MatthewBregg/OpenHopper/STL/BASE BLASTER/Grip/Trigger Grip Assembly.stl

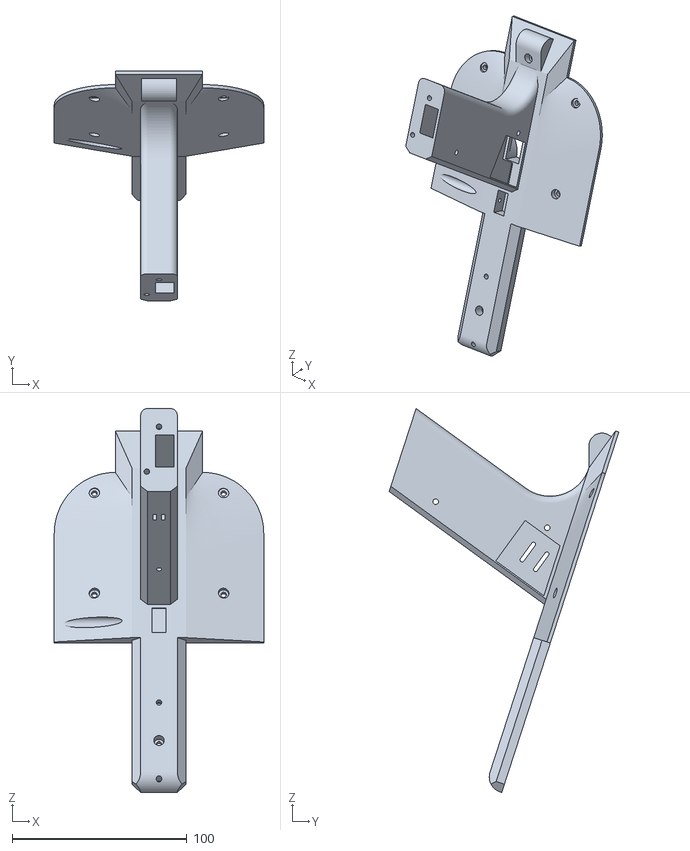
[picture p138: CAD file, 2021-02-06]
STL/BASE BLASTER/Grip/Trigger Grip Assembly.stl
120.0 x 131.6 x 219.9
