MatthewBregg/OpenHopper/STP/Trigger Grip Assembly.step

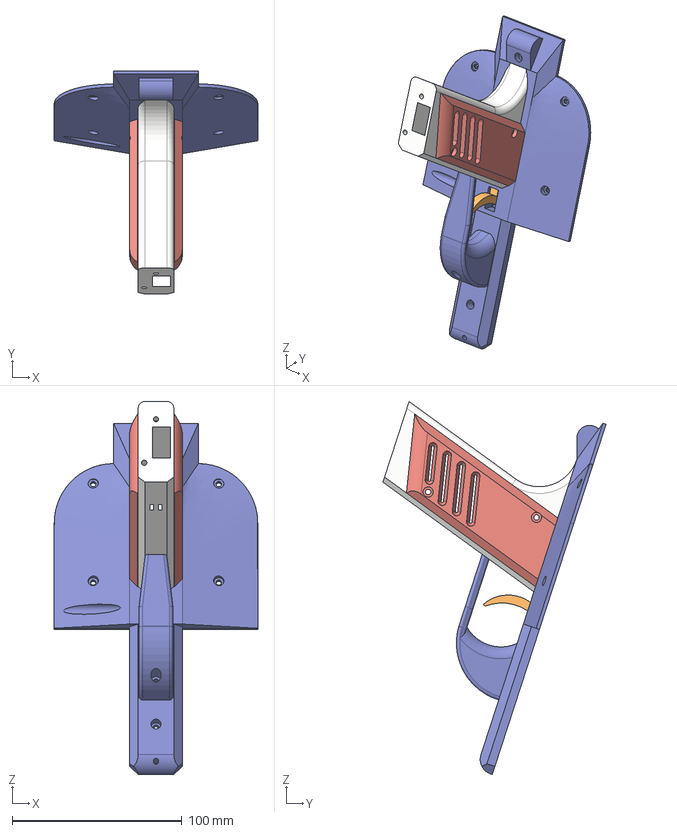
[picture p139: CAD file, 2021-02-24]
STP/Trigger Grip Assembly.step
120.0 x 131.6 x 219.9 mm
Trigger
Trigger Guard
Grip Sides
Grip Sides(Mirror)
