MatthewBregg/OpenHopper/STL/BASE BLASTER/FWC AND COVER/FWC.stl

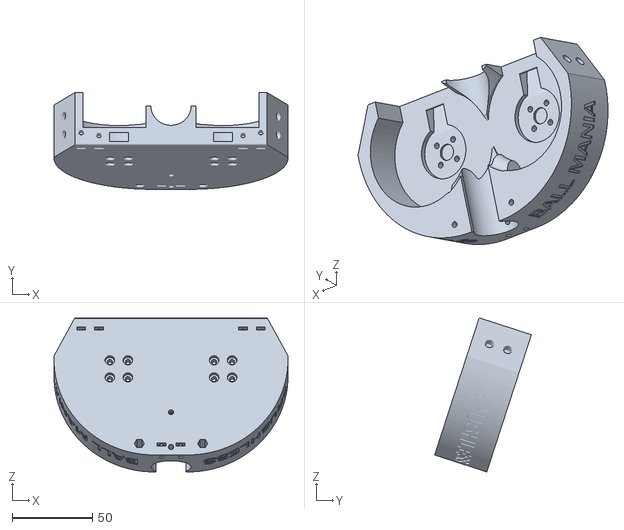
[picture p140: CAD file, 2021-02-22]
STL/BASE BLASTER/FWC AND COVER/FWC.stl
146.0 x 60.4 x 96.0
