MatthewBregg/OpenHopper/STL/BASE BLASTER/Grip/Grip Sides.stl

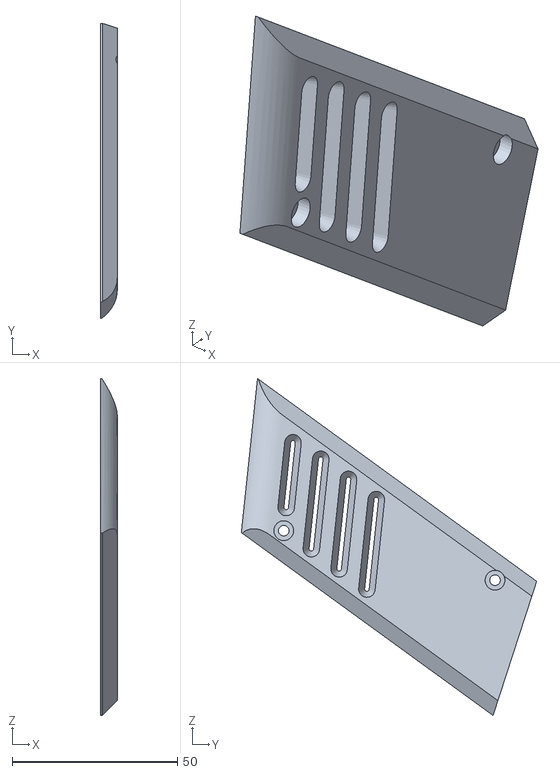
[picture p141: CAD file, 2021-02-06]
STL/BASE BLASTER/Grip/Grip Sides.stl
5.00 x 89.3 x 101.9
