MatthewBregg/OpenHopper/STL/BASE BLASTER/Hopper/easier_to_open_hopper_lid.stl

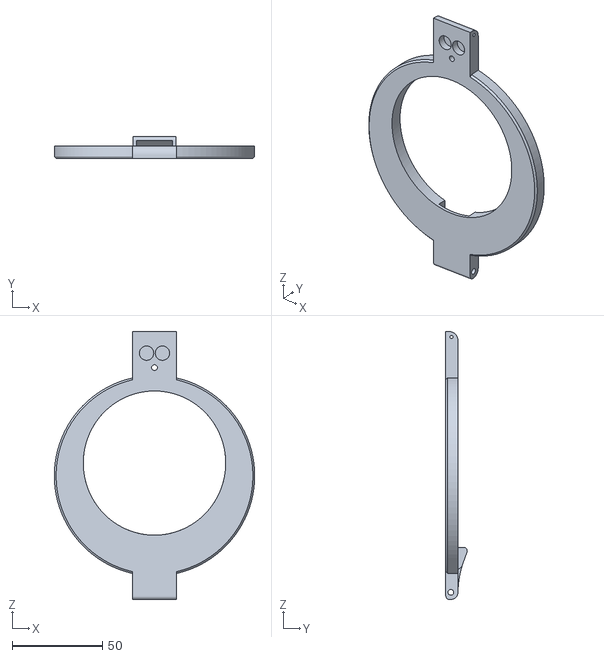
[picture p142: CAD file, 2021-04-23]
STL/BASE BLASTER/Hopper/easier_to_open_hopper_lid.stl
111.2 x 11.9 x 148.7
