MatthewBregg/OpenHopper/STL/BASE BLASTER/STOCK/lid.stl

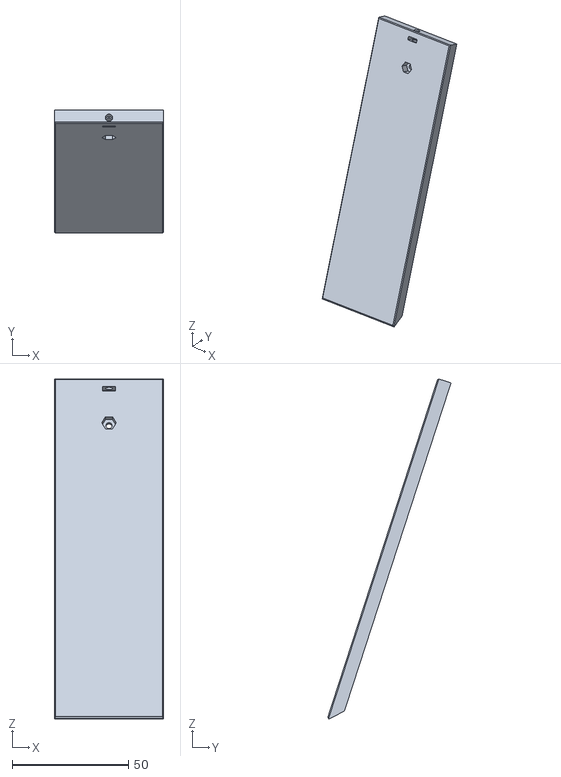
[picture p143: CAD file, 2021-02-23]
STL/BASE BLASTER/STOCK/lid.stl
47.0 x 53.0 x 146.4
