MatthewBregg/OpenHopper/STL/EXTRAs/Spidey logo disk_plated_mirrored_no_pegs.stl

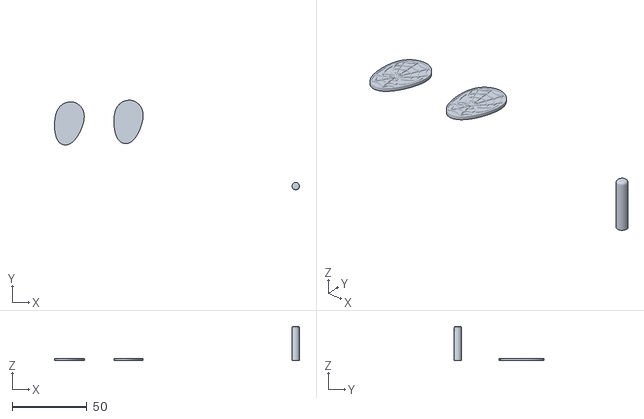
[picture p144: CAD file, 2021-02-24]
STL/EXTRAs/Spidey logo disk_plated_mirrored_no_pegs.stl
163.6 x 59.9 x 23.0
