MatthewBregg/OpenHopper/STP/Wing 2.0.step

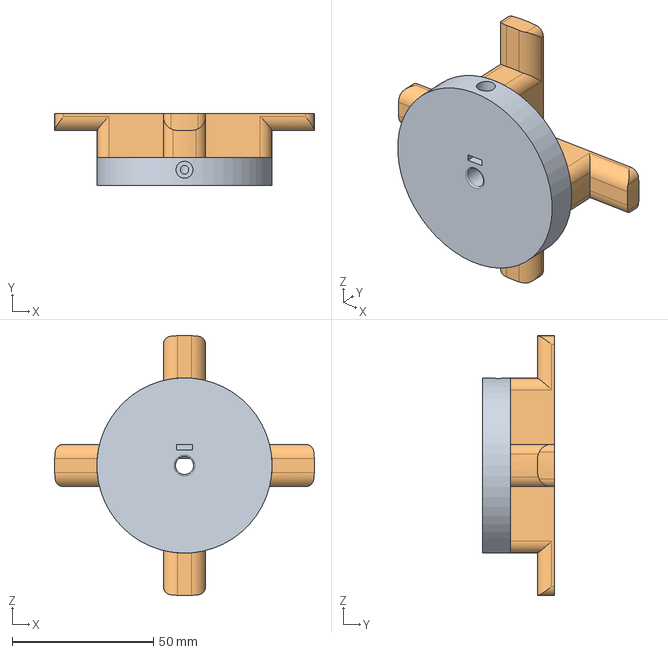
[picture p145: CAD file, 2021-02-24]
STP/Wing 2.0.step
92.0 x 25.5 x 92.0 mm
