MatthewBregg/OpenHopper/STL/BASE BLASTER/FWC AND COVER/Orb Weaver Sign A.stl

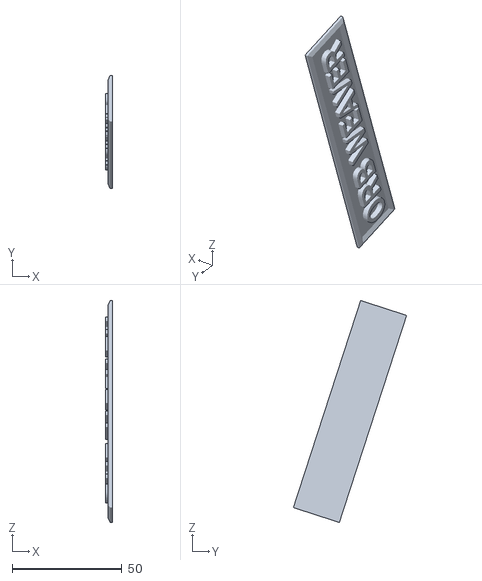
[picture p146: CAD file, 2021-02-21]
STL/BASE BLASTER/FWC AND COVER/Orb Weaver Sign A.stl
3.00 x 51.5 x 100.9
