MatthewBregg/OpenHopper/STL/BASE BLASTER/Hopper/Hopper.stl

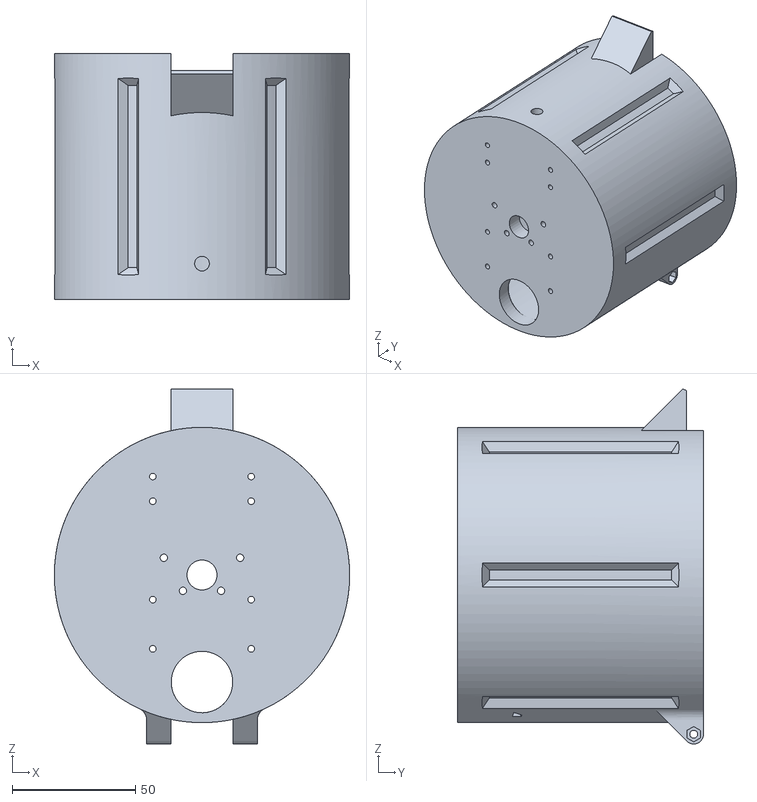
[picture p147: CAD file, 2021-02-23]
STL/BASE BLASTER/Hopper/Hopper.stl
120.0 x 100.0 x 144.3
