MatthewBregg/OpenHopper/STL/BASE BLASTER/STOCK/Stock Mounter.stl

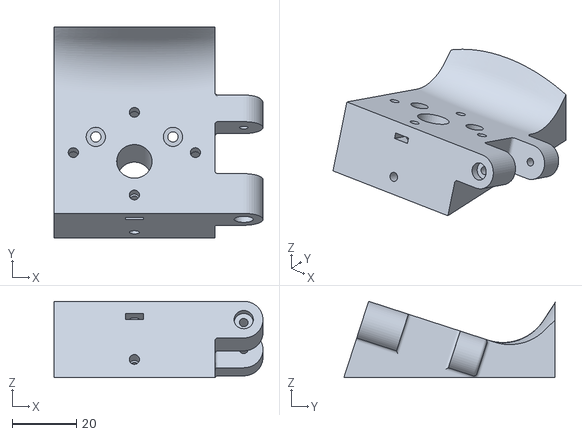
[picture p148: CAD file, 2021-02-06]
STL/BASE BLASTER/STOCK/Stock Mounter.stl
65.0 x 65.8 x 23.8
