MatthewBregg/OpenHopper/STL/EXTRAs/Angled foregrip.stl

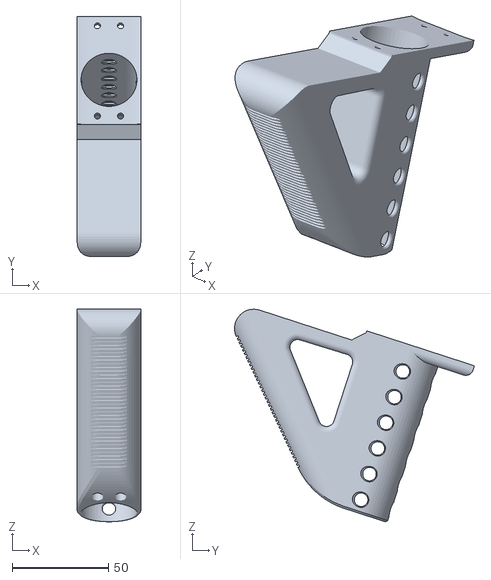
[picture p149: CAD file, 2021-02-23]
STL/EXTRAs/Angled foregrip.stl
33.0 x 124.6 x 110.4
