MatthewBregg/OpenHopper/STL/BASE BLASTER/Grip/Trigger.stl

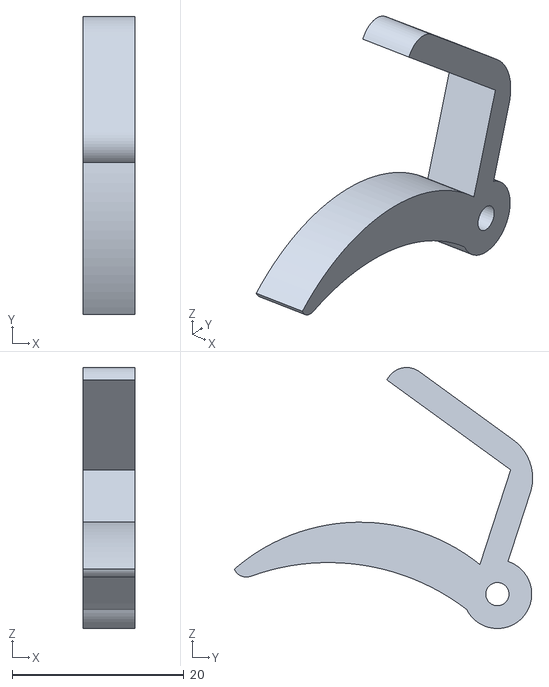
[picture p150: CAD file, 2021-02-06]
STL/BASE BLASTER/Grip/Trigger.stl
6.00 x 34.7 x 30.4
