MatthewBregg/OpenHopper/STL/BASE BLASTER/STOCK/Outer Stock.stl

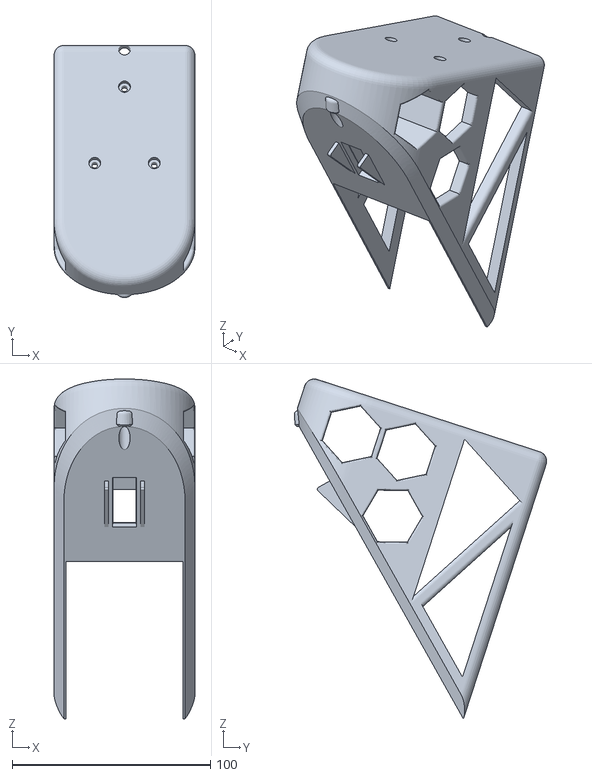
[picture p151: CAD file, 2021-02-06]
STL/BASE BLASTER/STOCK/Outer Stock.stl
71.0 x 127.2 x 171.4
