MatthewBregg/OpenHopper/STL/EXTRAs/Short Barrel.stl

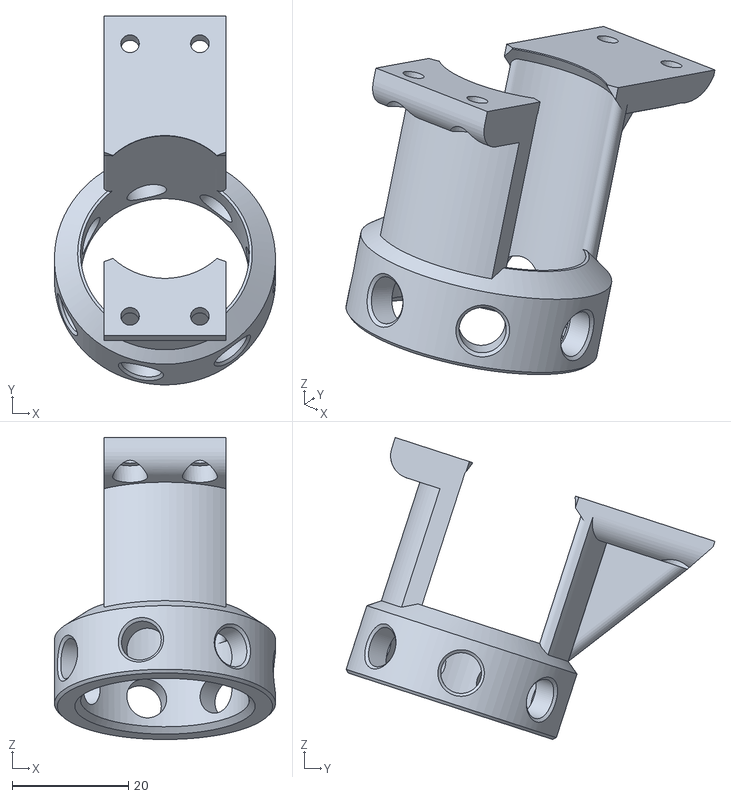
[picture p152: CAD file, 2021-02-23]
STL/EXTRAs/Short Barrel.stl
38.0 x 63.4 x 51.9
