MatthewBregg/OpenHopper/STP/FWC.step

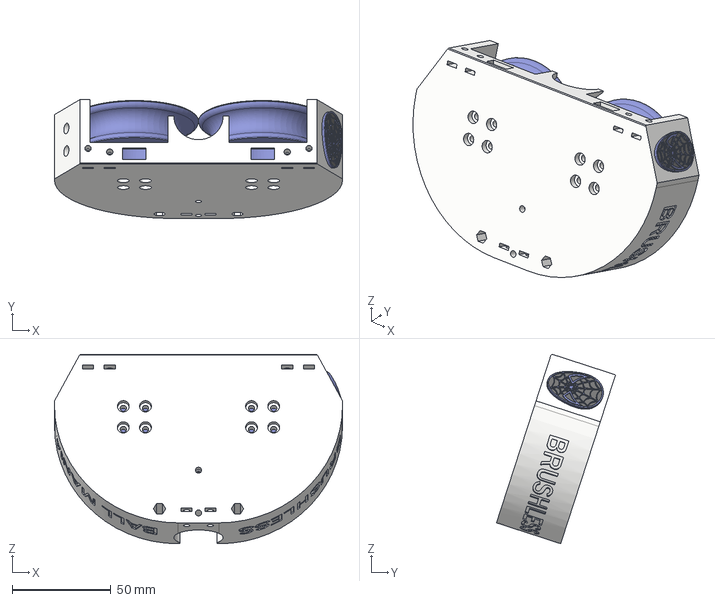
[picture p153: CAD file, 2021-02-24]
STP/FWC.step
146.0 x 60.4 x 96.0 mm
