MatthewBregg/OpenHopper/STL/BASE BLASTER/FWC AND COVER/Controller Compartment Lid With Rail.stl

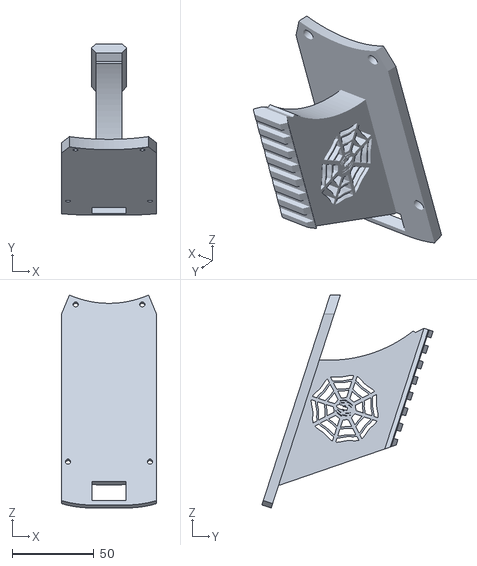
[picture p154: CAD file, 2021-02-21]
STL/BASE BLASTER/FWC AND COVER/Controller Compartment Lid With Rail.stl
58.0 x 104.5 x 129.9
