MatthewBregg/OpenHopper/STL/BASE BLASTER/Hopper/Plain Lid No speed loader.stl

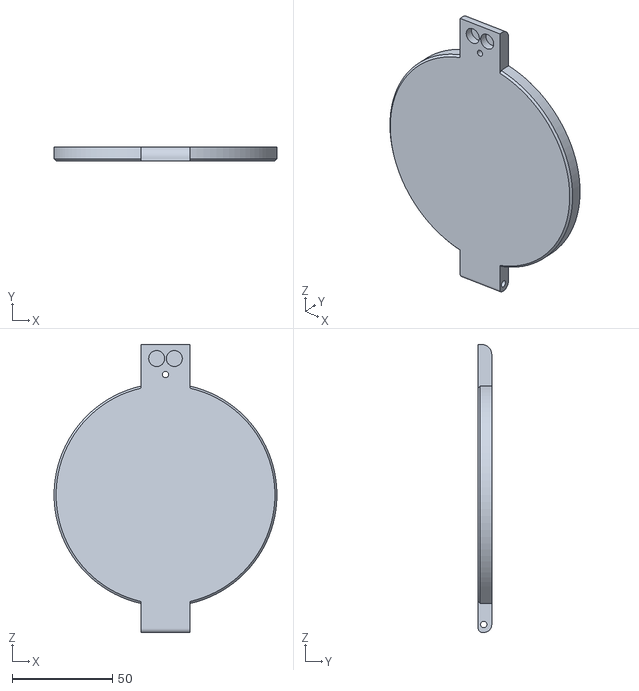
[picture p155: CAD file, 2021-02-12]
STL/BASE BLASTER/Hopper/Plain Lid No speed loader.stl
111.2 x 6.80 x 143.7
