MatthewBregg/OpenHopper/STL/BASE BLASTER/STOCK/stock_inner.stl

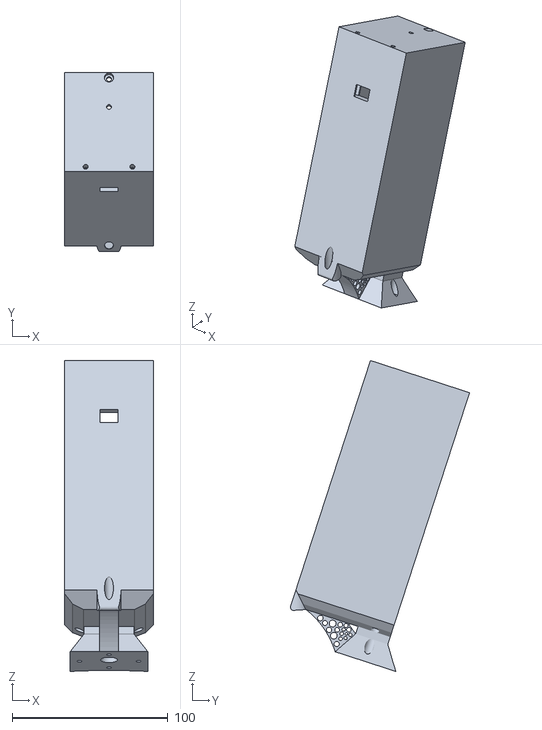
[picture p156: CAD file, 2021-02-06]
STL/BASE BLASTER/STOCK/stock_inner.stl
57.0 x 115.1 x 199.9
