MatthewBregg/OpenHopper/STL/EXTRAs/long_barrel.stl

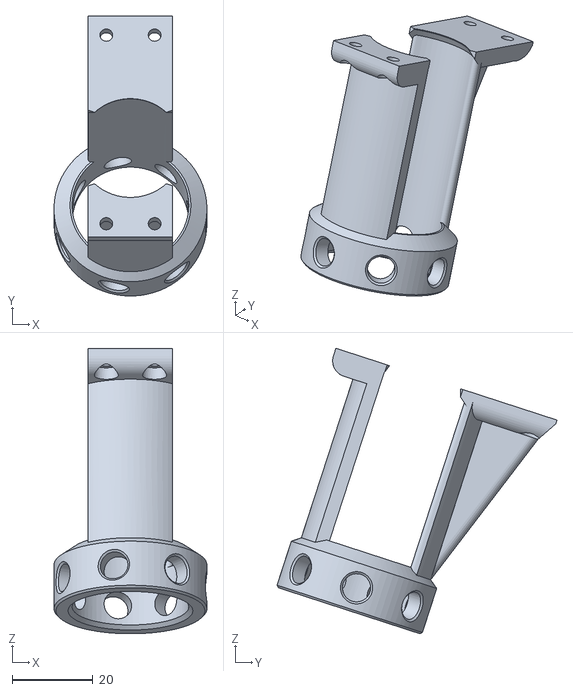
[picture p157: CAD file, 2021-02-23]
STL/EXTRAs/long_barrel.stl
38.0 x 69.6 x 70.9
