MatthewBregg/OpenHopper/STP/Stock Tube.step

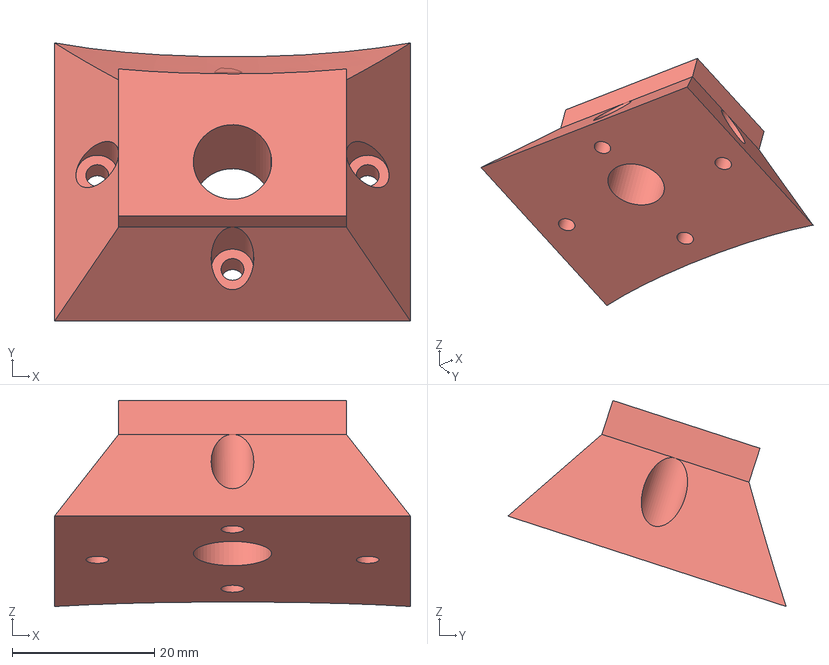
[picture p158: CAD file, 2021-02-24]
STP/Stock Tube.step
50.0 x 39.1 x 28.9 mm
