MatthewBregg/OpenHopper/STL/BASE BLASTER/FWC AND COVER/Controller Compartment Lid.stl

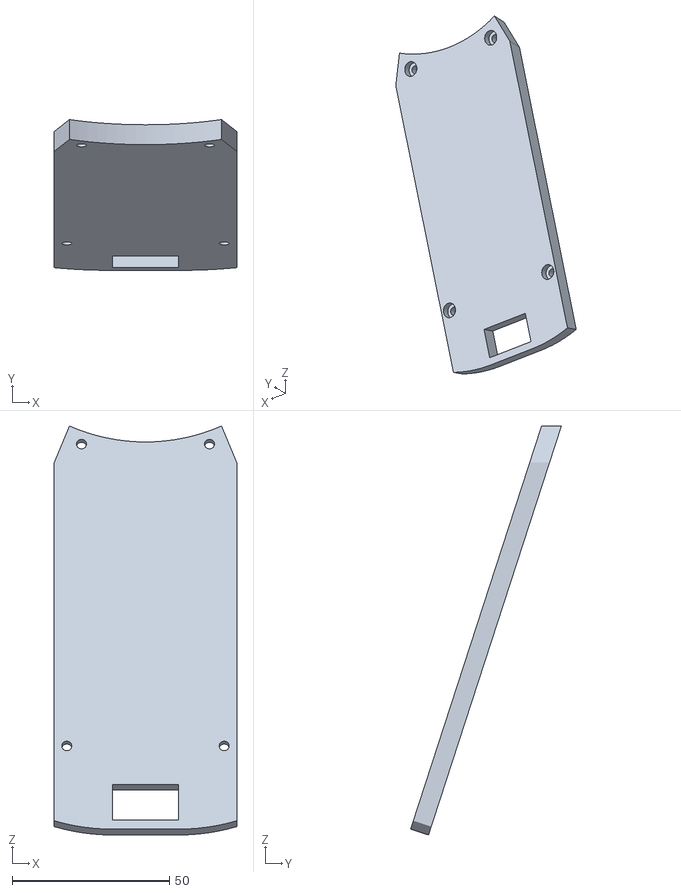
[picture p159: CAD file, 2021-02-06]
STL/BASE BLASTER/FWC AND COVER/Controller Compartment Lid.stl
58.0 x 47.9 x 129.9
