MatthewBregg/OpenHopper/STL/BASE BLASTER/Grip/Trigger Guard.stl

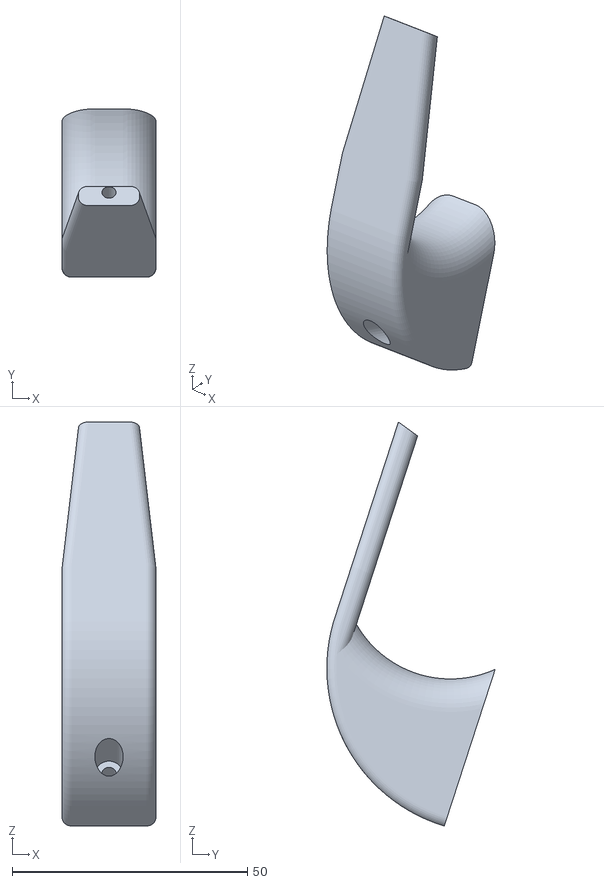
[picture p160: CAD file, 2021-02-06]
STL/BASE BLASTER/Grip/Trigger Guard.stl
20.0 x 35.8 x 85.8
