MatthewBregg/OpenHopper/STL/BASE BLASTER/Hopper/Spinner Motor Cover.stl

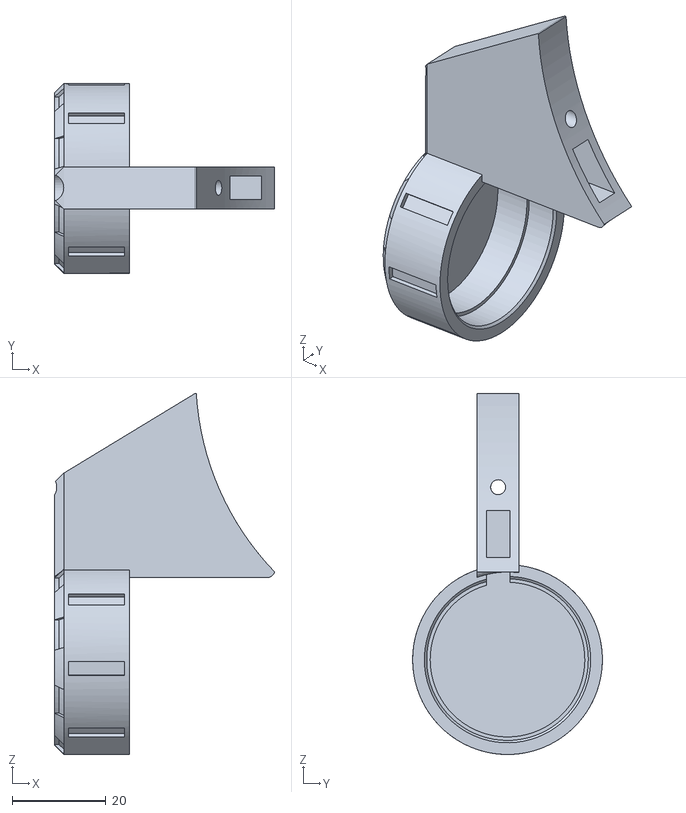
[picture p161: CAD file, 2021-02-06]
STL/BASE BLASTER/Hopper/Spinner Motor Cover.stl
47.0 x 40.5 x 77.0
