MatthewBregg/OpenHopper/STL/EXTRAs/Spidey logo disk.stl

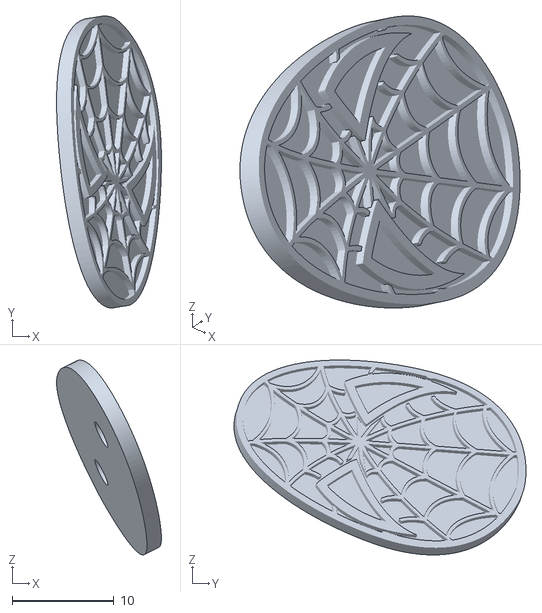
[picture p162: CAD file, 2021-02-22]
STL/EXTRAs/Spidey logo disk.stl
10.3 x 28.7 x 19.1
