MatthewBregg/OpenHopper/STL/BASE BLASTER/FWC AND COVER/FWC cover.stl

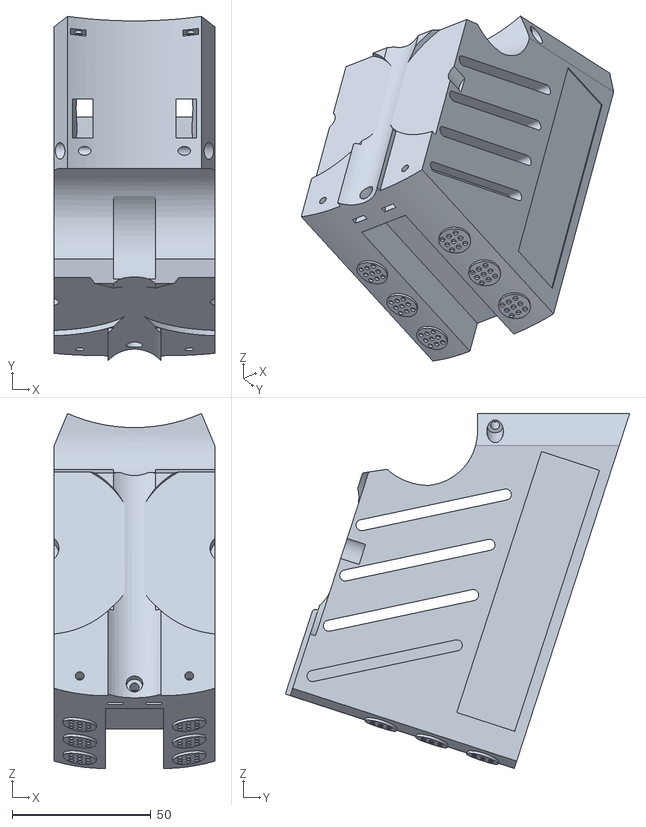
[picture p163: CAD file, 2021-02-06]
STL/BASE BLASTER/FWC AND COVER/FWC cover.stl
58.0 x 124.2 x 128.1
