MatthewBregg/OpenHopper/STL/BASE BLASTER/Hopper/HopperToFlywheelTube.stl

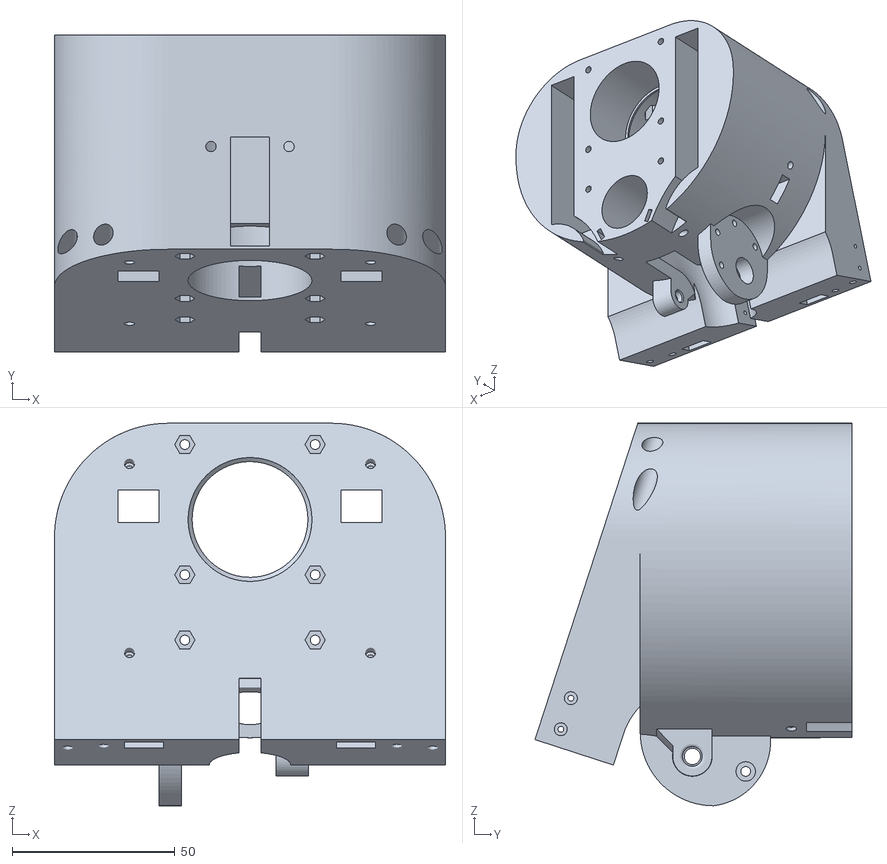
[picture p164: CAD file, 2021-02-06]
STL/BASE BLASTER/Hopper/HopperToFlywheelTube.stl
120.0 x 97.3 x 117.4
