MatthewBregg/OpenHopper/STL/EXTRAs/Spidey logo disk_plated_mirrored.stl

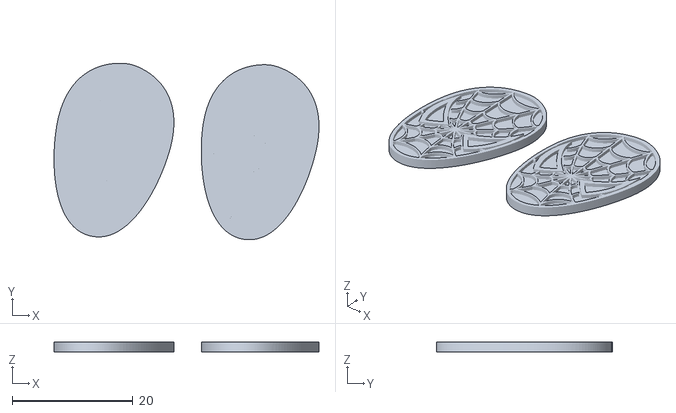
[picture p165: CAD file, 2021-02-22]
STL/EXTRAs/Spidey logo disk_plated_mirrored.stl
43.9 x 29.3 x 1.61
