MatthewBregg/OpenHopper/STP/Picatinny Rail.step

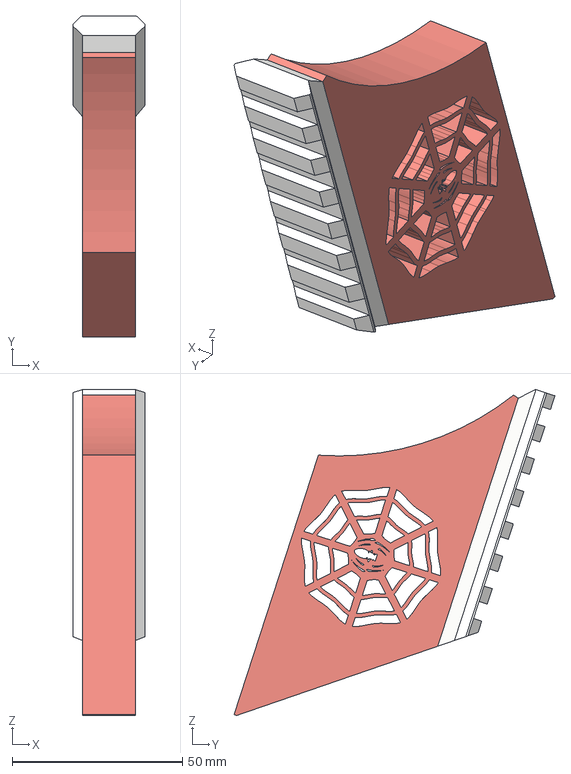
[picture p166: CAD file, 2021-02-24]
STP/Picatinny Rail.step
21.2 x 94.1 x 95.6 mm
