MatthewBregg/OpenHopper/STL/BASE BLASTER/FWC AND COVER/Flywheel.stl

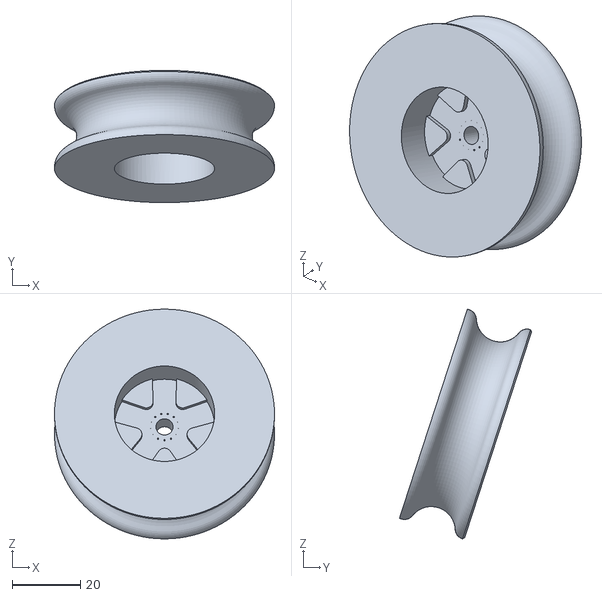
[picture p167: CAD file, 2021-02-06]
STL/BASE BLASTER/FWC AND COVER/Flywheel.stl
64.5 x 38.8 x 67.4
