MatthewBregg/OpenHopper/STL/BASE BLASTER/Hopper/New Lid with space for feed gate.stl

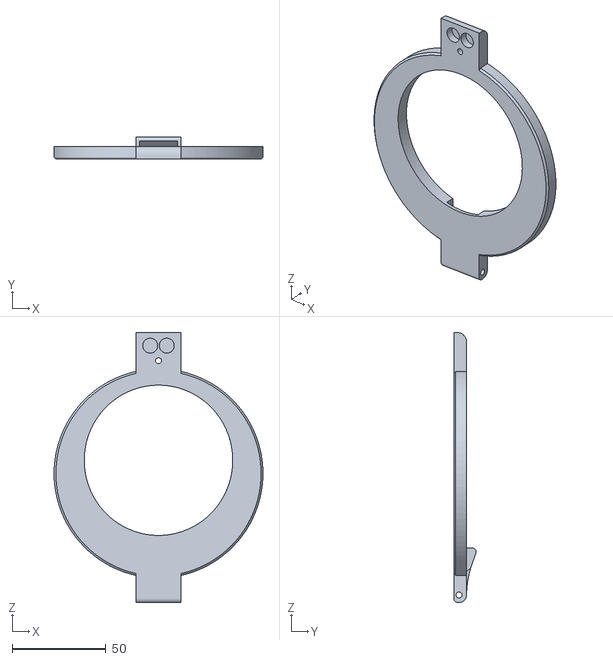
[picture p168: CAD file, 2021-02-06]
STL/BASE BLASTER/Hopper/New Lid with space for feed gate.stl
111.2 x 11.9 x 143.7
