MatthewBregg/OpenHopper/STL/EXTRAs/UnderGrip Flashlight Mount.stl

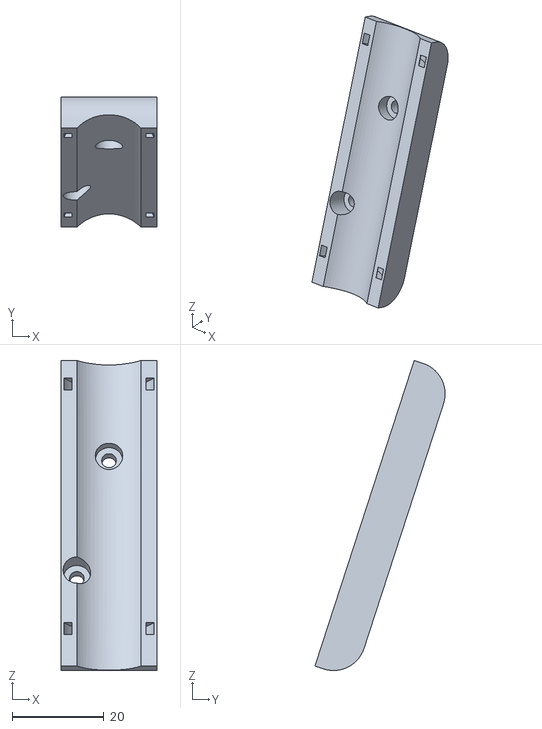
[picture p169: CAD file, 2021-02-06]
STL/EXTRAs/UnderGrip Flashlight Mount.stl
21.0 x 28.4 x 67.5
