MatthewBregg/OpenHopper/STP/Short Barrel.step

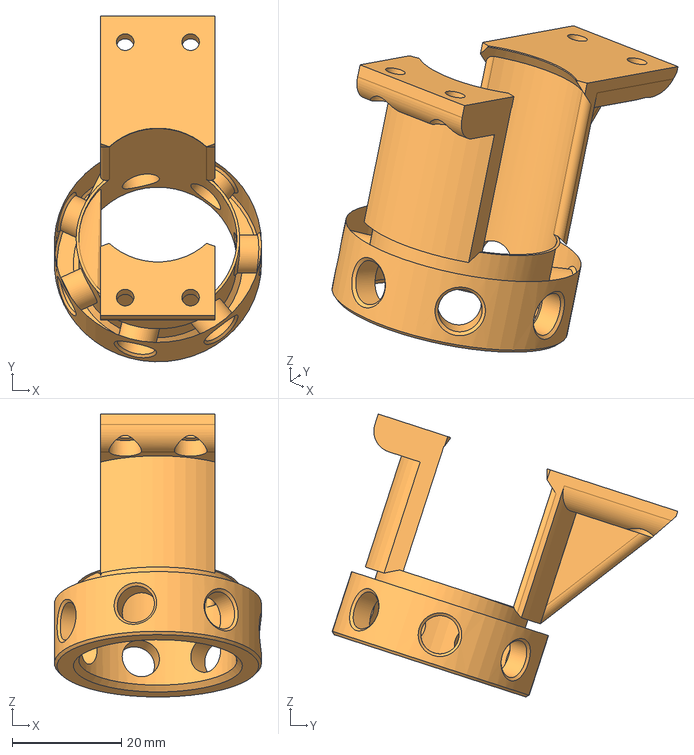
[picture p170: CAD file, 2021-02-24]
STP/Short Barrel.step
38.0 x 63.4 x 51.9 mm
