MatthewBregg/OpenHopper/STL/BASE BLASTER/Hopper/Spinner.stl

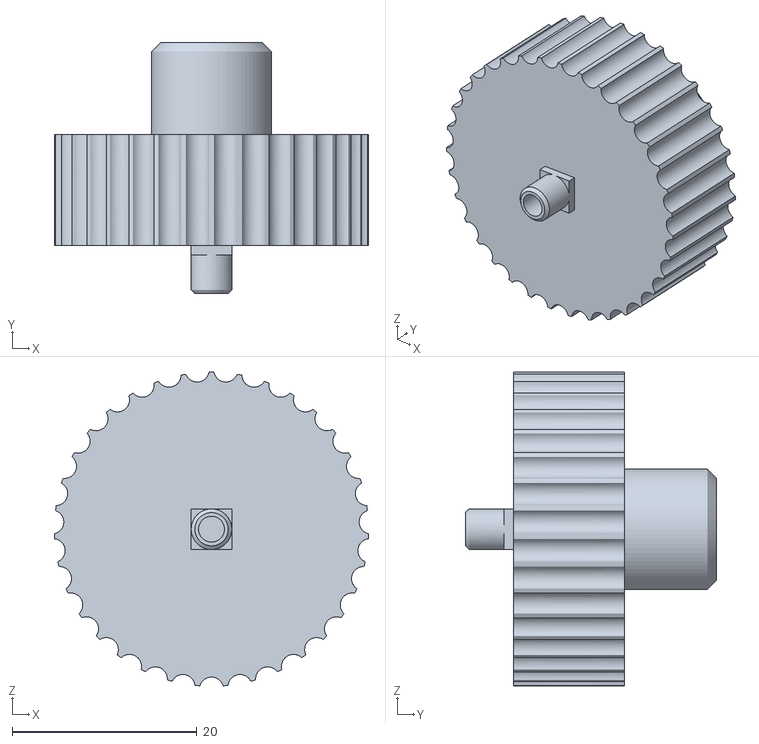
[picture p171: CAD file, 2021-01-24]
STL/BASE BLASTER/Hopper/Spinner.stl
34.0 x 27.2 x 34.0
