MatthewBregg/OpenHopper/STP/Angled Hopper.step

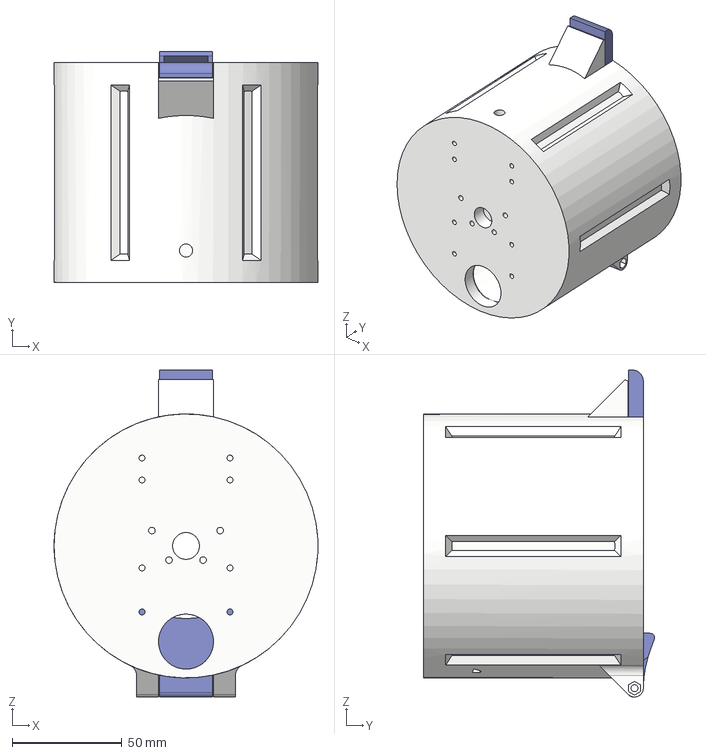
[picture p172: CAD file, 2021-02-24]
STP/Angled Hopper.step
120.0 x 105.1 x 148.7 mm
