MatthewBregg/OpenHopper/STP/FWC Cover and Hop Up.step

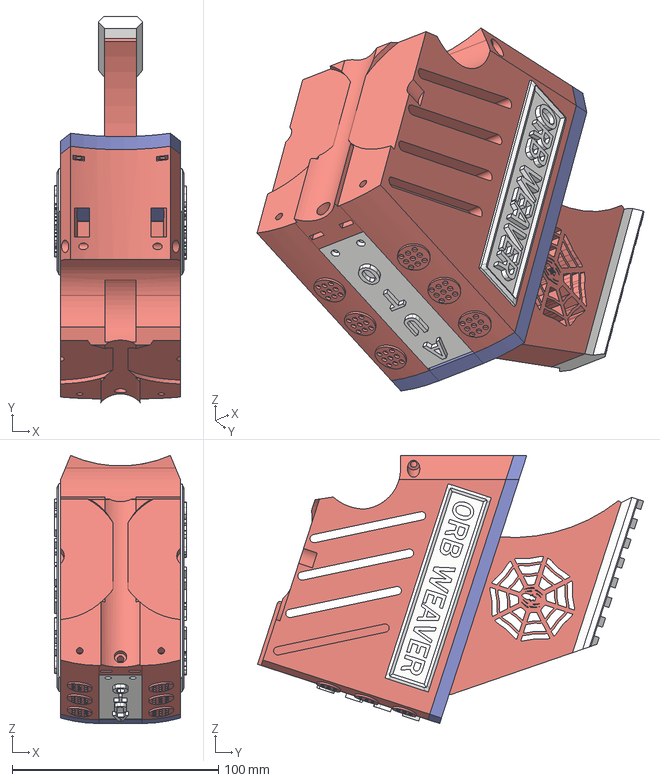
[picture p173: CAD file, 2021-02-24]
STP/FWC Cover and Hop Up.step
64.0 x 187.1 x 129.9 mm
