MatthewBregg/OpenHopper/STP/Trigger Guard.step

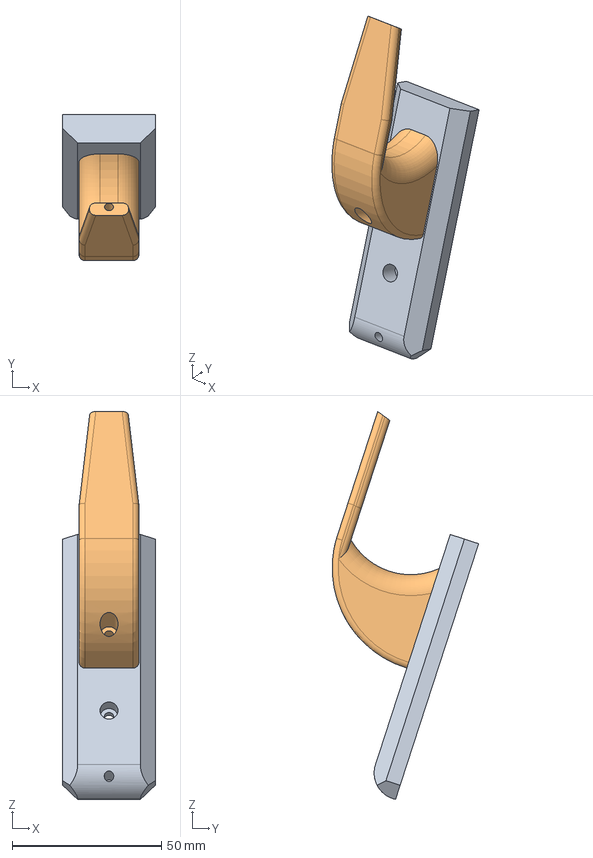
[picture p174: CAD file, 2021-02-24]
STP/Trigger Guard.step
31.0 x 49.0 x 129.8 mm
