MatthewBregg/OpenHopper/STP/Battery Box.step

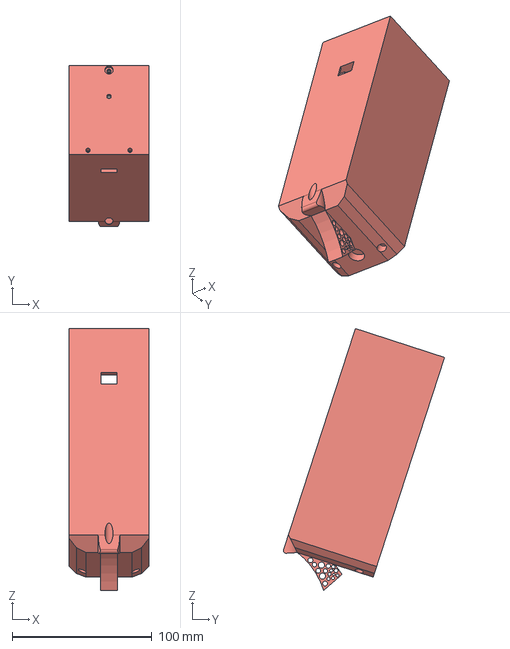
[picture p175: CAD file, 2021-02-24]
STP/Battery Box.step
57.0 x 115.1 x 187.1 mm
