MatthewBregg/OpenHopper/(list of files, cad)

Other CAD files:
STP/Grip Sides(Mirror).step
STL/BASE BLASTER/FWC AND COVER/Orb Weaver Sign B.stl
STL/BASE BLASTER/Hopper/wings.stl
STL/BASE BLASTER/Grip/Grip Sides(Mirror).stl
STP/Spinner Motor Cover.step
STL/EXTRAs/Flywheel_18-4_M_HEIGHT.stl
STP/Angled foregrip.step
STL/EXTRAs/Flywheel_18-3_M_HEIGHT.stl
STL/EXTRAs/Flywheel_18-5_M_HEIGHT.stl
STP/Grip Sides.step
STP/Trigger.step
STP/HopperToFlywheelTube.step
STP/UnderGrip Flashlight Mount.step
STP/Stock Mounter.step
STP/Outer Stock.step
STL/BASE BLASTER/FWC AND COVER/Hop up nut insert cover.stl
