MatthewBregg/OpenHopper/STL/BUILD_GUIDE/2_2_nut_holes.png

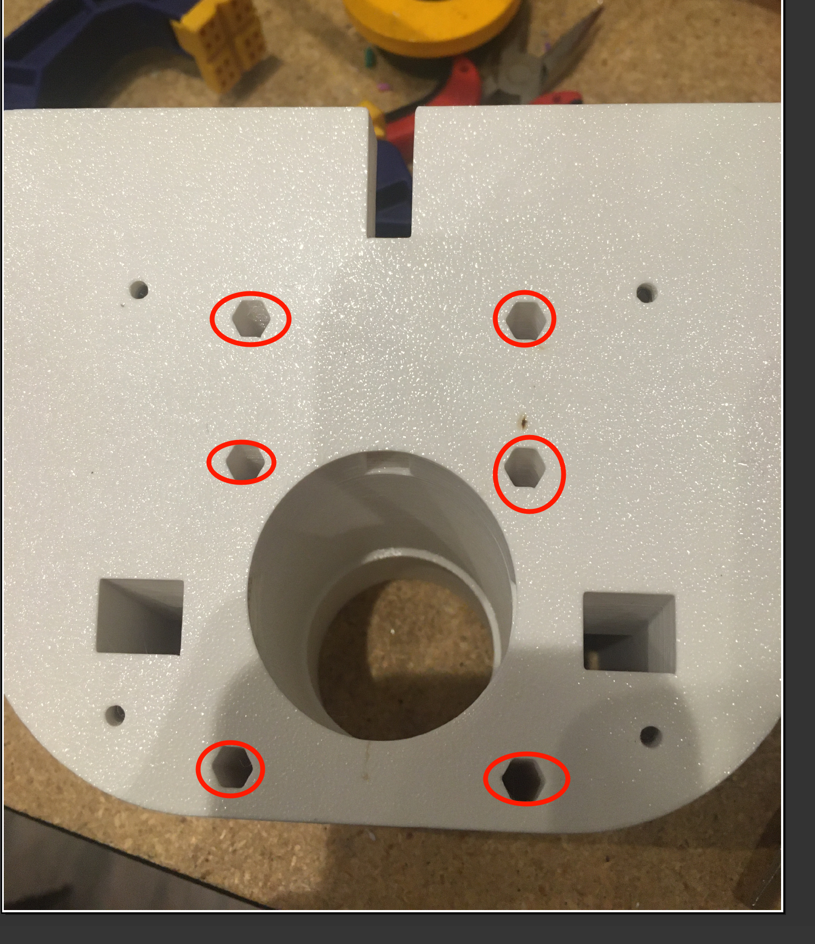
STL/BUILD_GUIDE/2_2_nut_holes.png
