MatthewBregg/OpenHopper/STL/BUILD_GUIDE/8_2_0.jpg

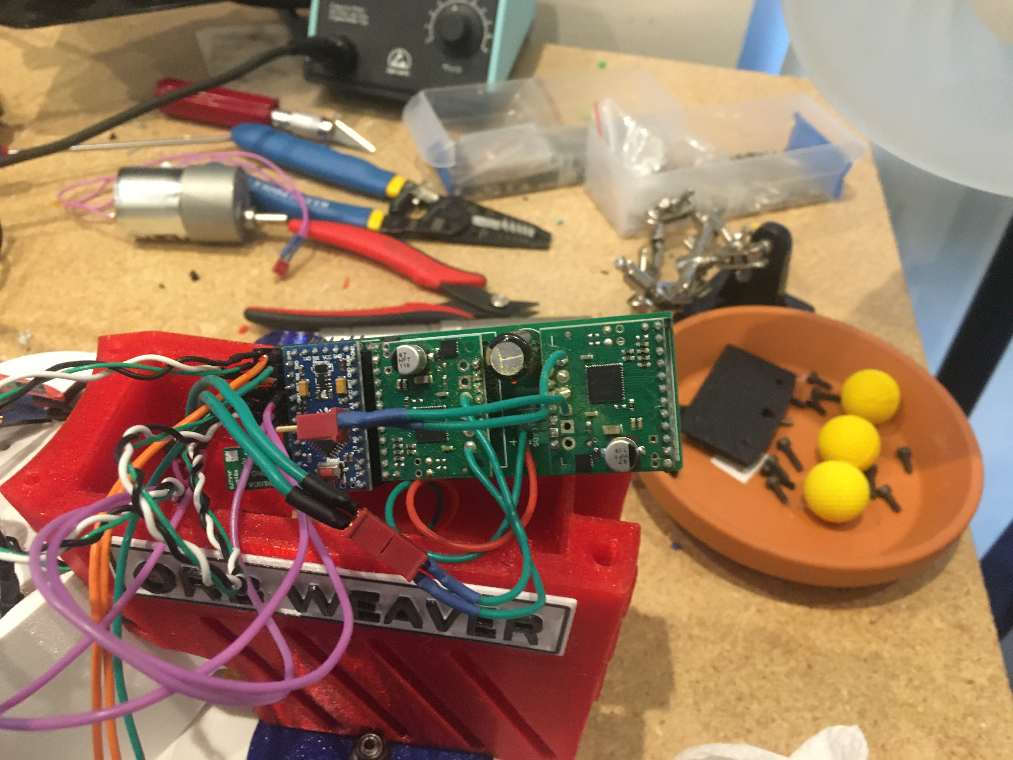
STL/BUILD_GUIDE/8_2_0.jpg
