MatthewBregg/OpenHopper/STL/BUILD_GUIDE/11_0_6.png

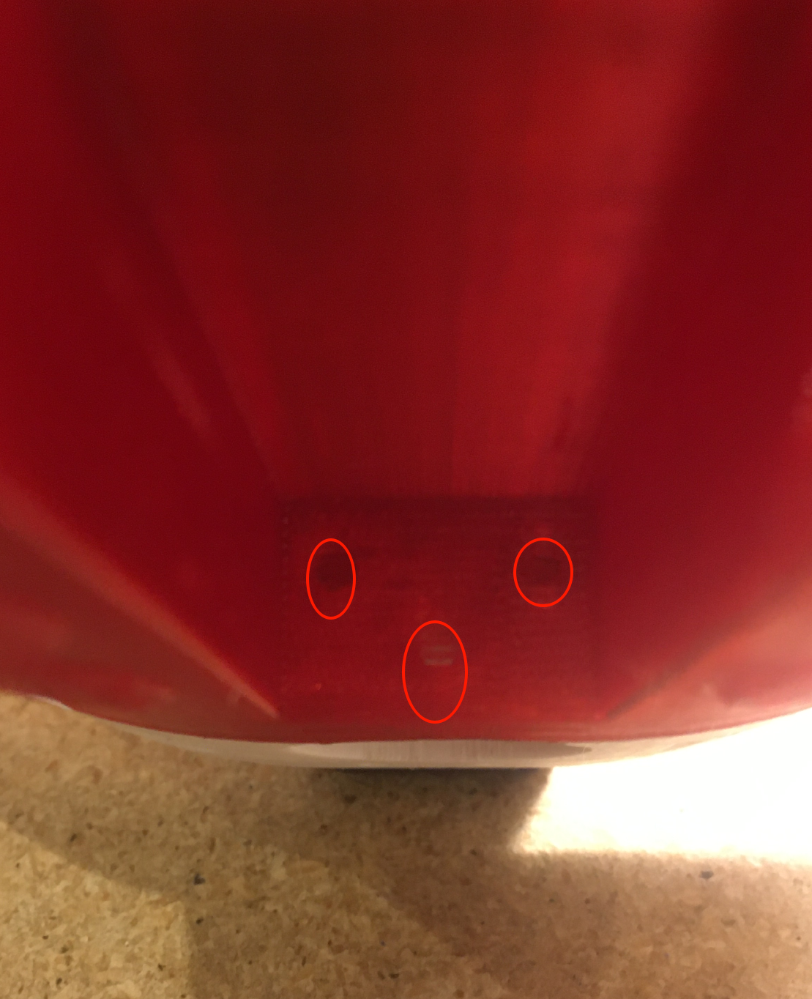
STL/BUILD_GUIDE/11_0_6.png
