MatthewBregg/OpenHopper/STL/BUILD_GUIDE/12_0_0.jpg

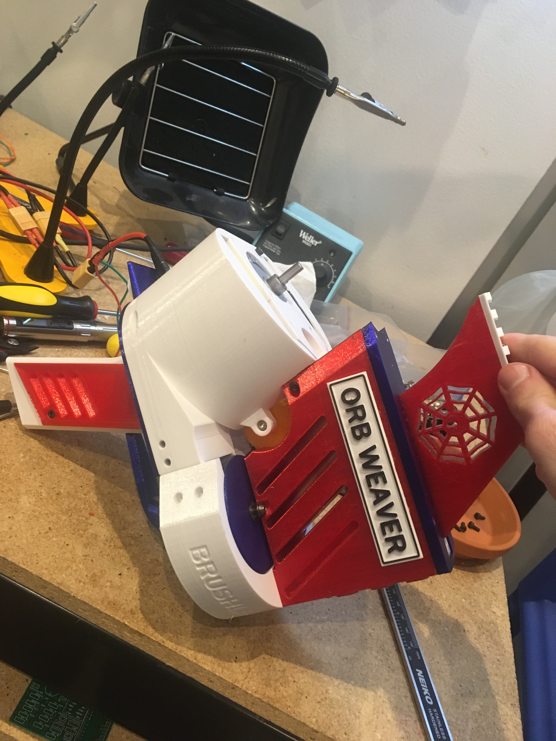
STL/BUILD_GUIDE/12_0_0.jpg
