MatthewBregg/OpenHopper/STL/BUILD_GUIDE/15_0_1.jpg

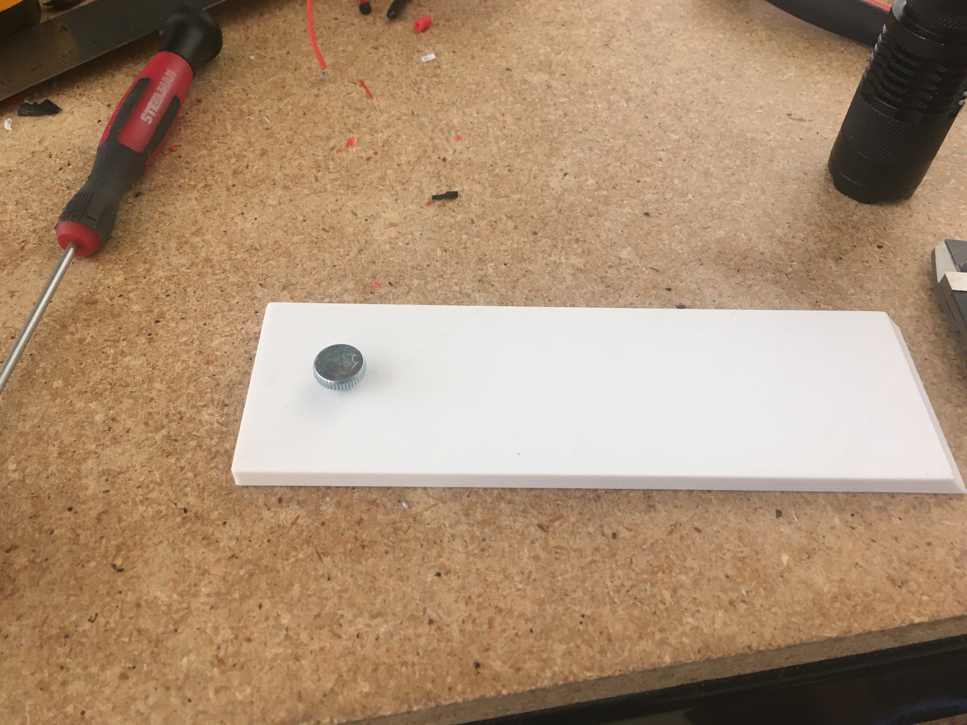
STL/BUILD_GUIDE/15_0_1.jpg
