MatthewBregg/OpenHopper/STL/BUILD_GUIDE/fwc_assembly_1_2_4.jpg

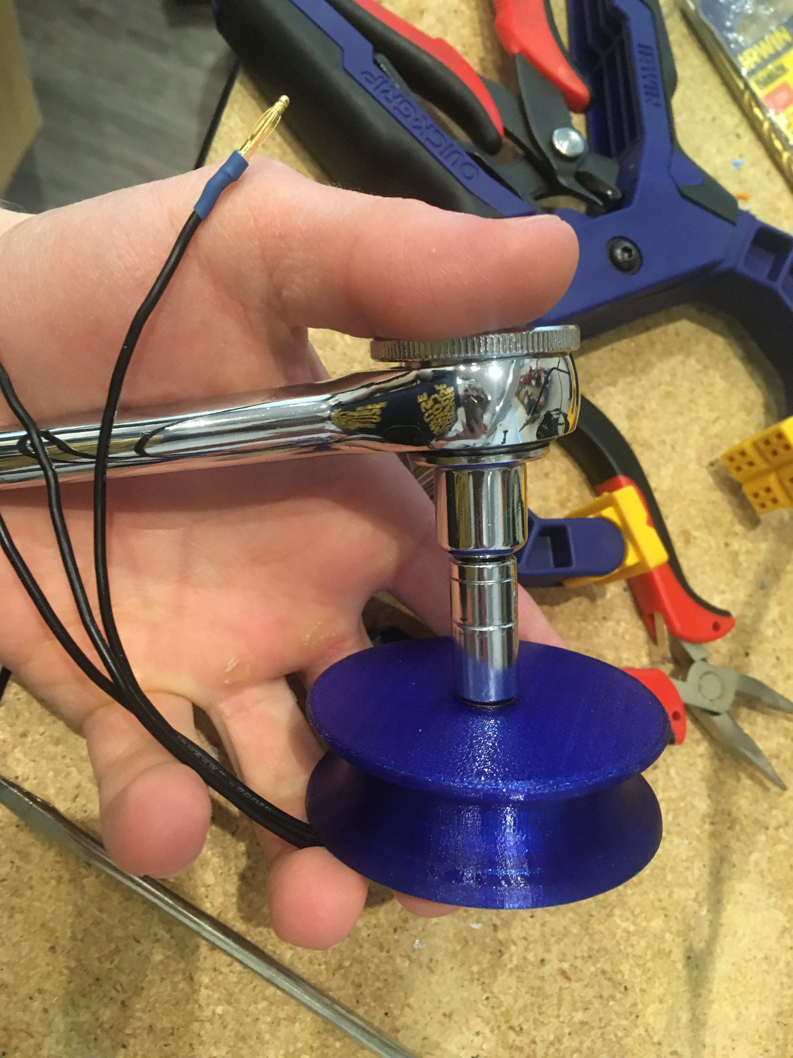
STL/BUILD_GUIDE/fwc_assembly_1_2_4.jpg
