MatthewBregg/OpenHopper/(commit log)

2020-12-20 Switch over to the TB67H420FTG drivers
2020-12-20 Use a constant for motor speed
2021-01-24 Add stl file dump
    [Angled Hopper.stl, FWC Cover and Hop Up.stl, FWC Cover.stl, FWC.stl, HopperToFlywheelTube.stl, Stock Mounter.stl, Trigger Grip Assembly.stl, roller v18.stl]
2021-01-26 Add some variety of flywheels at different motor heights for tight groove filler tolerence issues (Although I just loosened the tolerences also to help as well).
    [Flywheel_18-3_M_HEIGHT.stl, Flywheel_18-4_M_HEIGHT.stl, Flywheel_18-5_M_HEIGHT.stl]
2021-02-06 Cosmetics done
    [Spidey Logo Disc_small.stl, spidey_logo_disk_big.stl]
2021-02-06 Start on the build guide
    [Angled Hopper.stl, Battery Box Lid No Switch.stl, Controller Compartment Lid.stl, FWC Cover and Hop Up.stl, FWC Cover.stl, FWC.stl, Flywheel (1).stl, Flywheel_18-3_M_HEIGHT.stl]
2021-02-12 Start work on build guide
    [Plain Lid No speed loader.stl, lid.stl]
2021-02-17 Continuing printing out for the build guide
    [Flywheel.stl]
2021-02-18 Finish printing all components of hopper section
    [Spinner.stl, wings.stl]
2021-02-19 Continue printing parts
2021-02-21 Done printing
    [Controller Compartment Lid With Rail.stl, FWC cover.stl, Orb Weaver Sign A.stl, Orb Weaver Sign B.stl, Picatinny Rail.stl, spidey_logo_disks_mirrored.stl]
2021-02-21 Forgot to print hop up
2021-02-21 Fix FWC glitch
    [FWC.stl]
2021-02-21 FWC assembly step added
2021-02-22 Starting to assembler the feedneck
2021-02-22 Cycle switch installed
2021-02-22 Grip assembled
2021-02-22 Flywheel cage update
    [FWC.stl, Spidey Logo Disc_small.stl, Spidey logo disk.stl, Spidey logo disk_plated_mirrored.stl, spidey_logo_disk_big.stl, spidey_logo_disks_mirrored.stl]
2021-02-22 Added main power switch model info
2021-02-22 Yet another fwc bug
    [FWC.stl]
2021-02-23 Wired the feed neck
2021-02-23 Fully assembled!
2021-02-23 Add indents for FWC cover lid nuts
    [Angled Hopper.stl, Hopper.stl]
2021-02-23 New battery lid
    [lid.stl]
2021-02-23 New lid with bigger magnetic clasp to enable easier grapping and opening
    [easier_to_open_hopper_lid.stl]
2021-02-23 Throw up some untested barrels
    [Angled foregrip.stl, Short Barrel.stl, long_barrel.stl]
2021-02-23 Added battery door directions
2021-02-24 Added PCB section to guide
    [Spidey logo disk_plated_mirrored_no_pegs.stl]
2021-02-24 Posting stp files
    [Angled Hopper.step, Angled foregrip.step, Battery Box.step, FWC Cover and Hop Up.step, FWC.step, Grip Sides(Mirror).step, Grip Sides.step, HopperToFlywheelTube.step]
2021-04-23 Add a little screw hole for a tiny bit more leverage on the lid
    [easier_to_open_hopper_lid.stl]
2021-04-24 Update the motor PWM cont., and also only trigger trap at end on timeout
2021-04-24 Actually, updating motor speed is pretty expensive the way I do it, so lets only do it during noncritical firing sections. The wheels should already be fully spun up once we begin firing, so pack sag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
    [rival_hopper.ino.ino]
