MatthewBregg/OpenHopper/STL/BUILD_GUIDE/motor_bullet_connectors.jpg

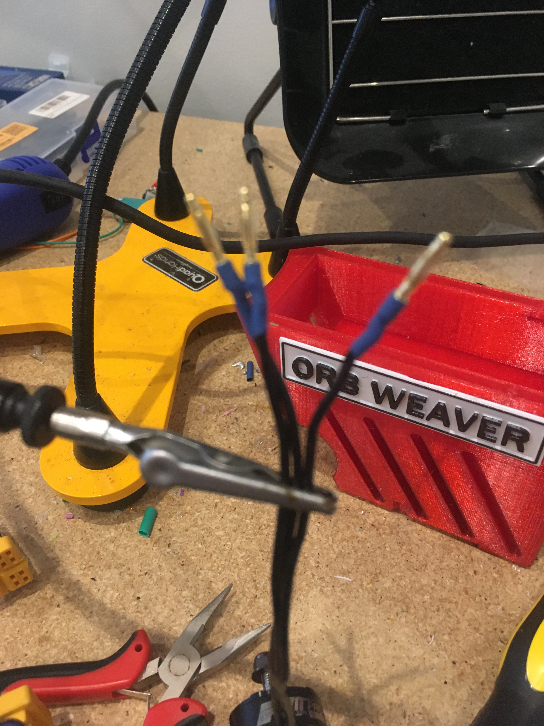
[picture p33: STL/BUILD_GUIDE/motor_bullet_connectors.jpg]
STL/BUILD_GUIDE/motor_bullet_connectors.jpg
