MatthewBregg/OpenHopper/STL/BUILD_GUIDE/fwc_assembly_1_3_0.jpg

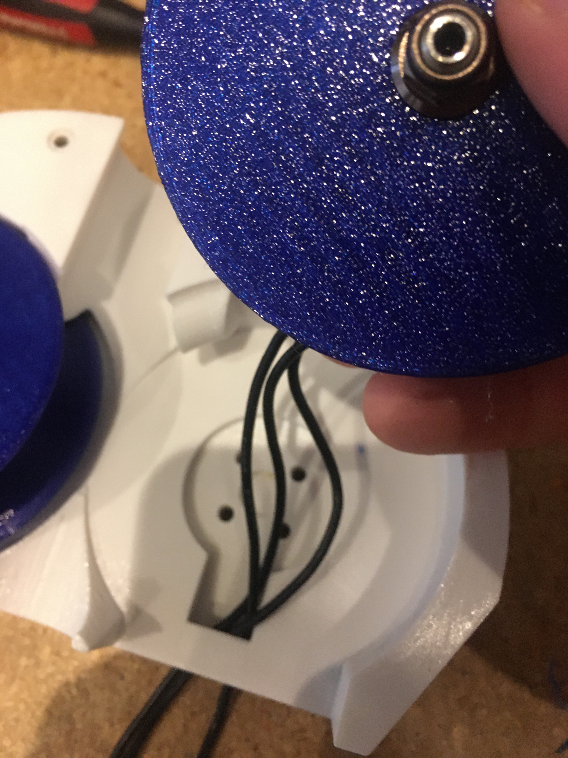
[picture p37: STL/BUILD_GUIDE/fwc_assembly_1_3_0.jpg]
STL/BUILD_GUIDE/fwc_assembly_1_3_0.jpg
