MatthewBregg/OpenHopper/STL/BUILD_GUIDE/2_5_0.jpg

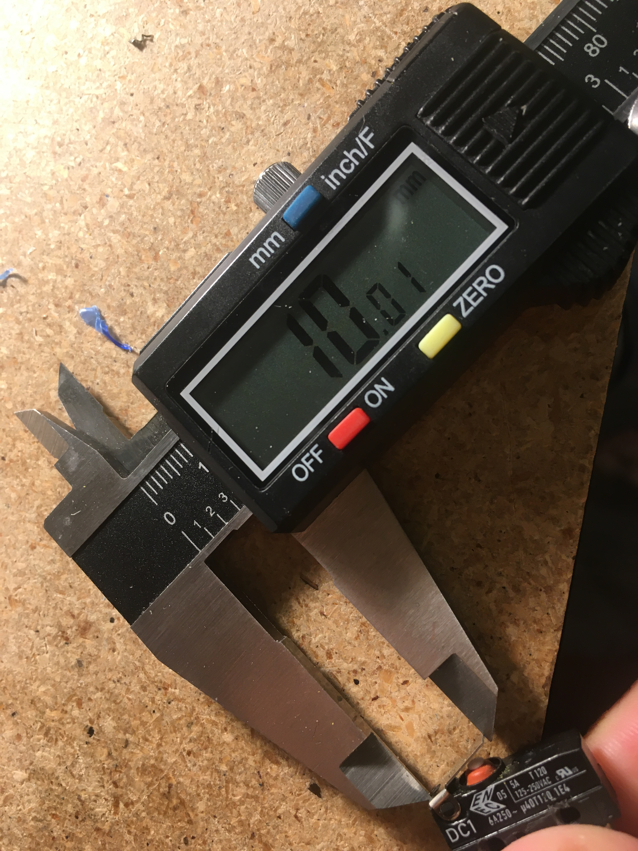
[picture p49: STL/BUILD_GUIDE/2_5_0.jpg]
STL/BUILD_GUIDE/2_5_0.jpg
