MatthewBregg/OpenHopper/STL/BUILD_GUIDE/2_8_0.jpg

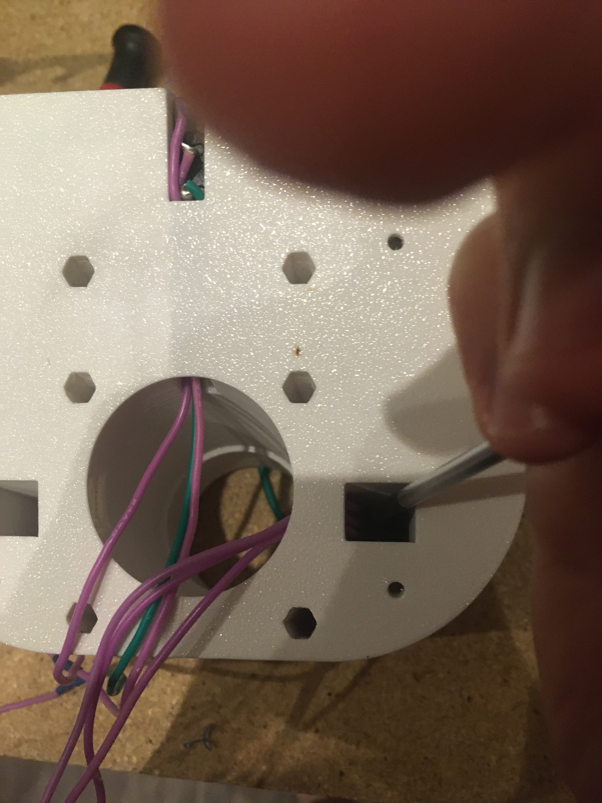
[picture p53: STL/BUILD_GUIDE/2_8_0.jpg]
STL/BUILD_GUIDE/2_8_0.jpg
