MatthewBregg/OpenHopper/STL/BUILD_GUIDE/2_7_7.jpg

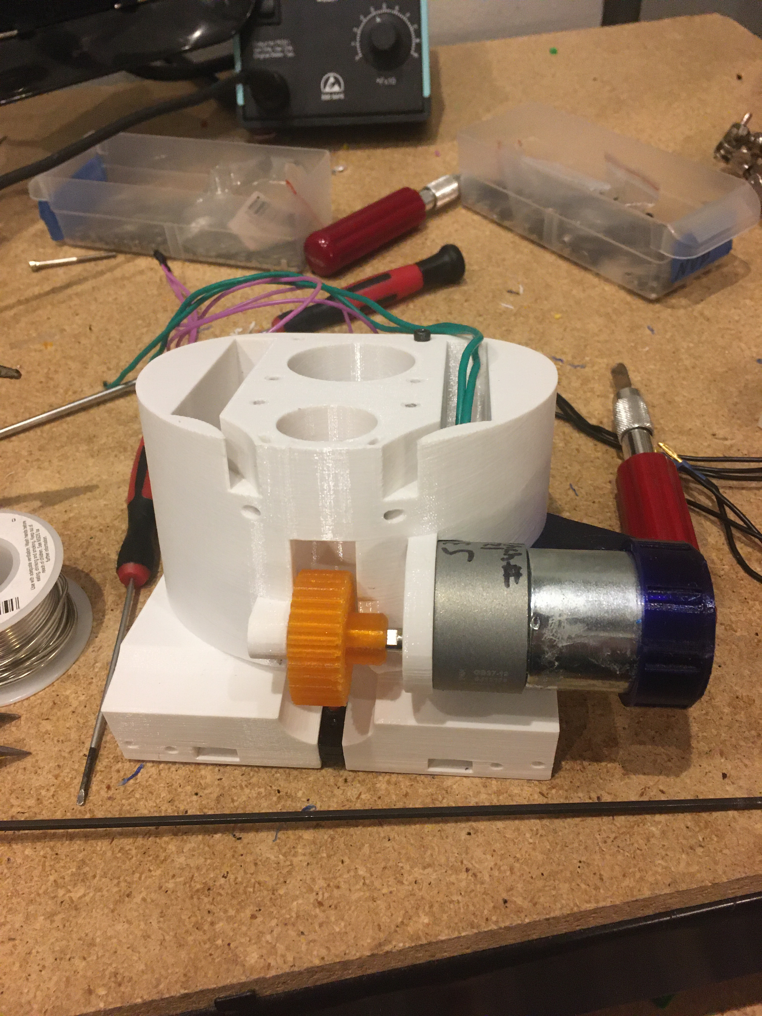
[picture p62: STL/BUILD_GUIDE/2_7_7.jpg]
STL/BUILD_GUIDE/2_7_7.jpg
