MatthewBregg/OpenHopper/STL/BUILD_GUIDE/5_1_1.jpg

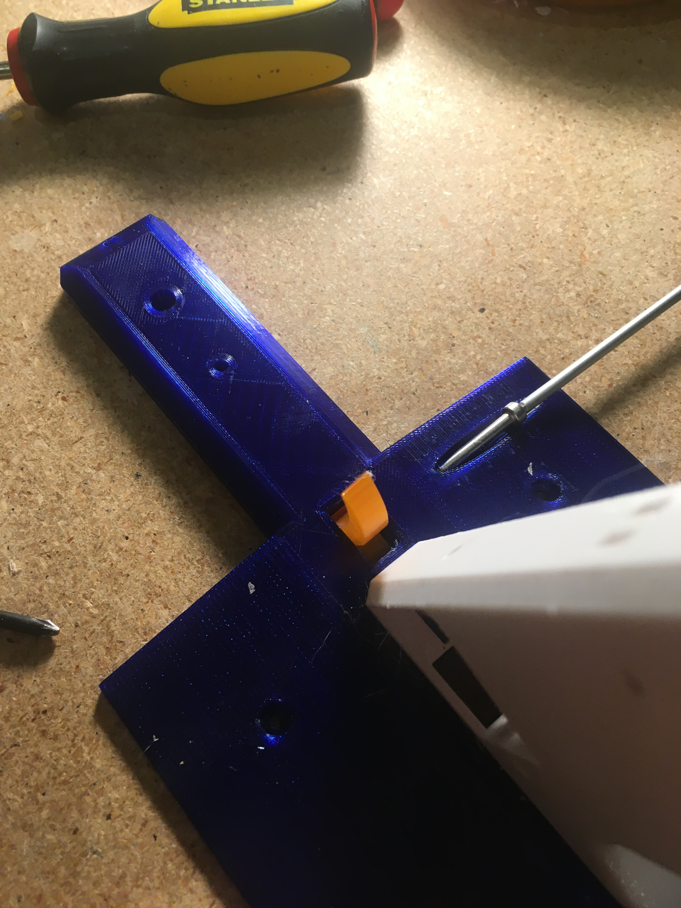
[picture p71: STL/BUILD_GUIDE/5_1_1.jpg]
STL/BUILD_GUIDE/5_1_1.jpg
