MatthewBregg/OpenHopper/STL/BUILD_GUIDE/5_2_4.jpg

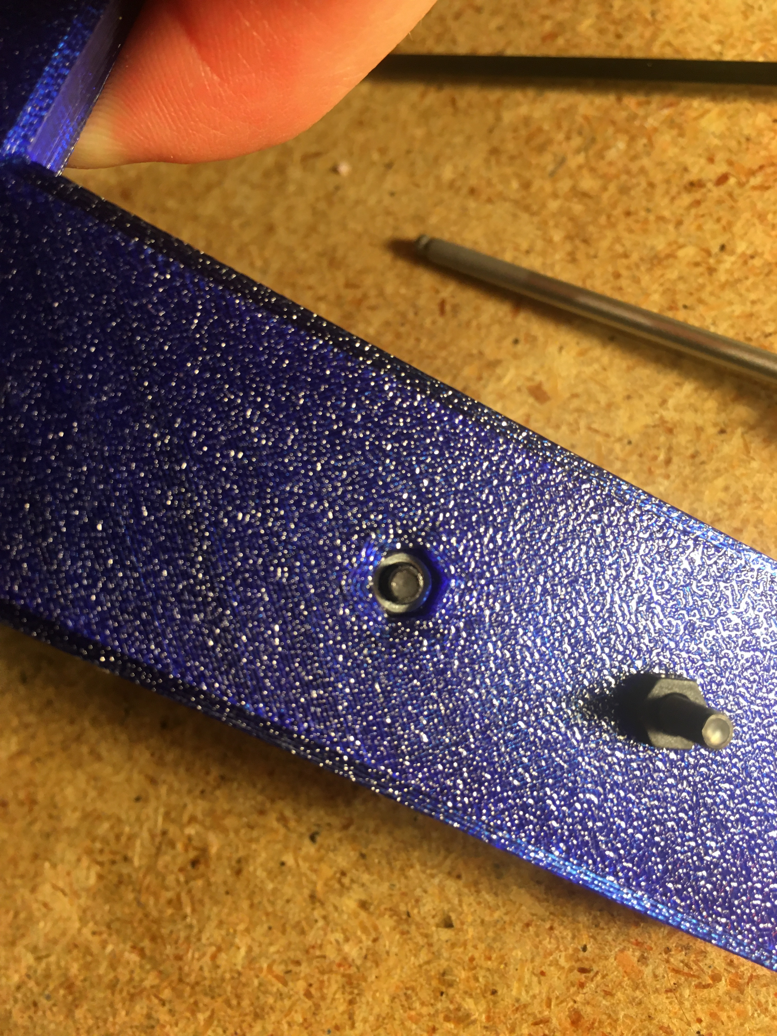
[picture p76: STL/BUILD_GUIDE/5_2_4.jpg]
STL/BUILD_GUIDE/5_2_4.jpg
