MatthewBregg/OpenHopper/STL/BUILD_GUIDE/5_4_0.jpg

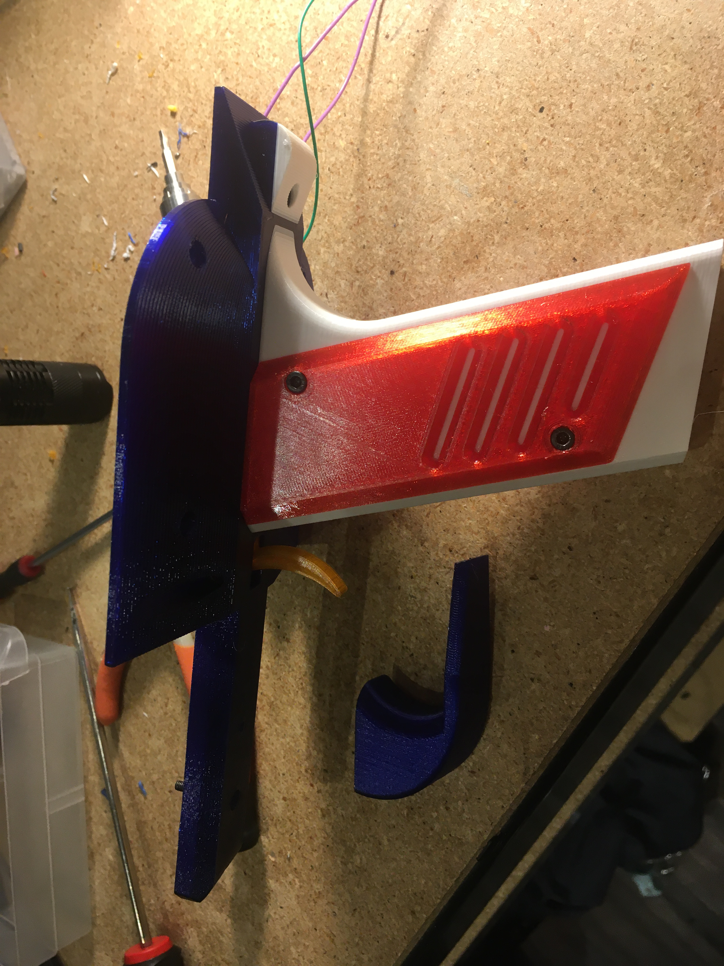
[picture p79: STL/BUILD_GUIDE/5_4_0.jpg]
STL/BUILD_GUIDE/5_4_0.jpg
