MatthewBregg/OpenHopper/STL/BUILD_GUIDE/6_1_2.jpg

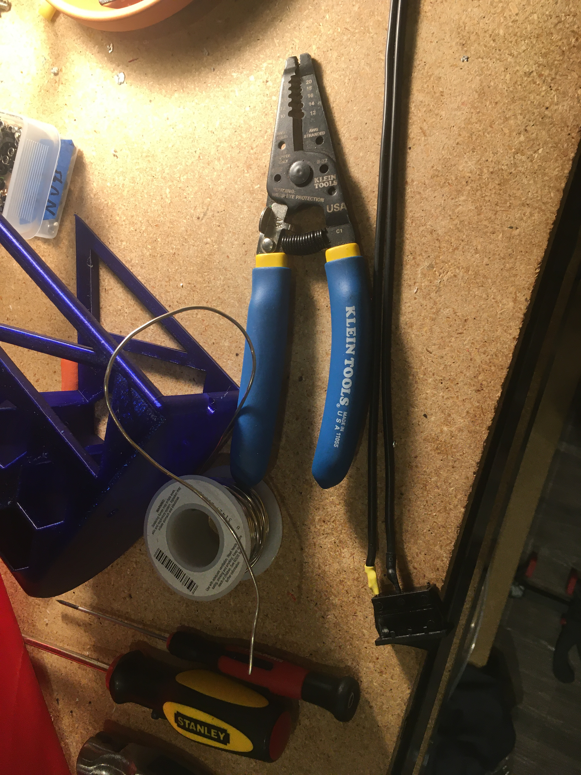
[picture p83: STL/BUILD_GUIDE/6_1_2.jpg]
STL/BUILD_GUIDE/6_1_2.jpg
