MatthewBregg/OpenHopper/STL/BUILD_GUIDE/8_0_1.jpg

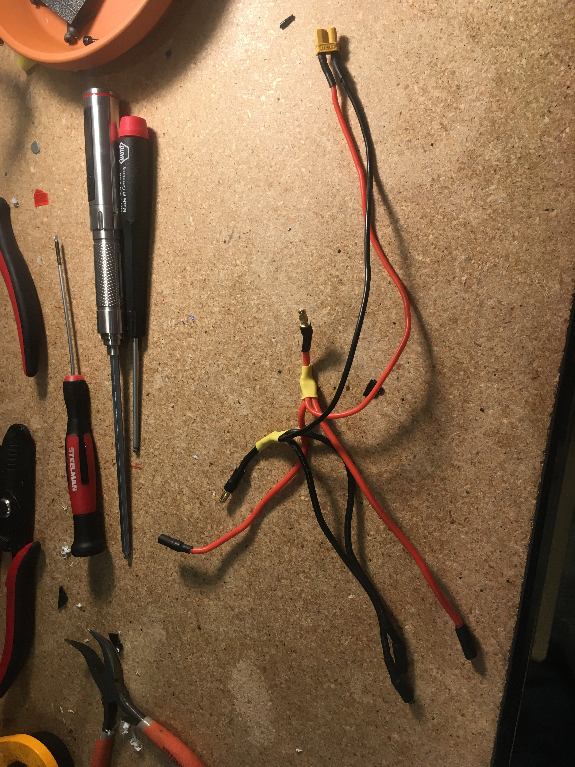
[picture p95: STL/BUILD_GUIDE/8_0_1.jpg]
STL/BUILD_GUIDE/8_0_1.jpg
