MatthewBregg/OpenHopper/STL/BUILD_GUIDE/8_3_0.jpg

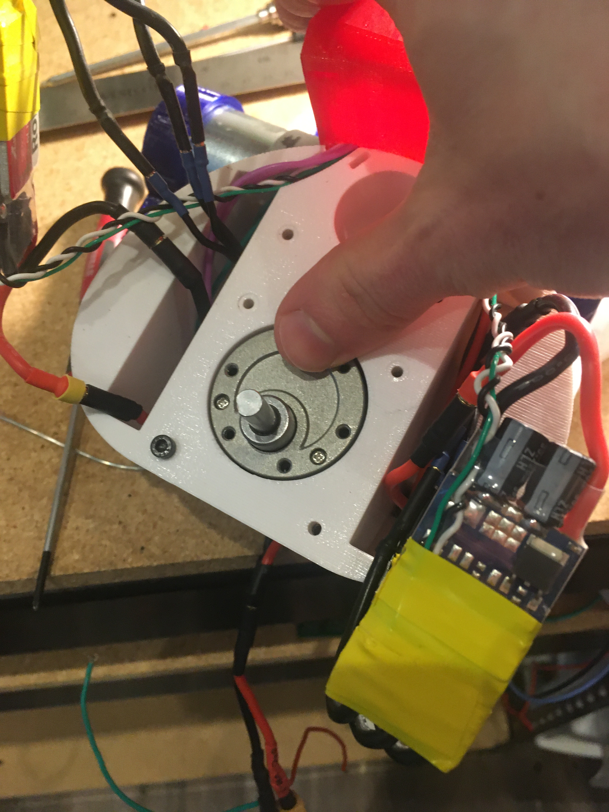
[picture p98: STL/BUILD_GUIDE/8_3_0.jpg]
STL/BUILD_GUIDE/8_3_0.jpg
