MatthewBregg/OpenHopper/STL/BUILD_GUIDE/11_0_2.jpg

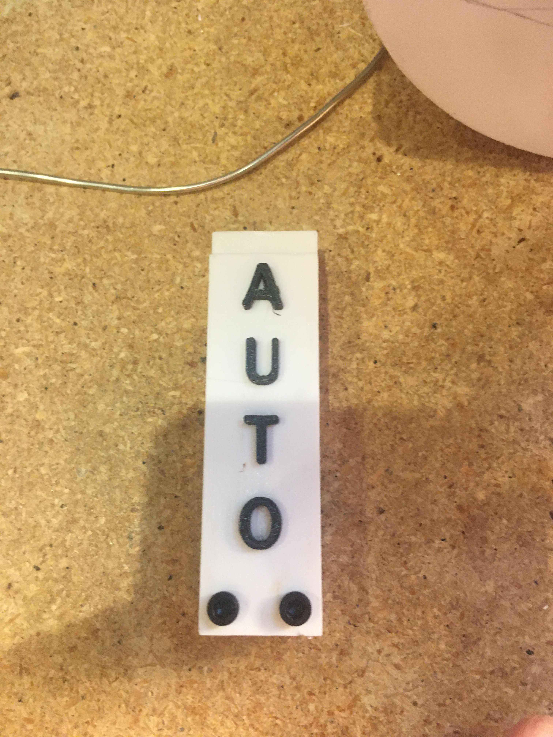
[picture p107: STL/BUILD_GUIDE/11_0_2.jpg]
STL/BUILD_GUIDE/11_0_2.jpg
