MatthewBregg/OpenHopper/STL/BUILD_GUIDE/13_2_0.jpg

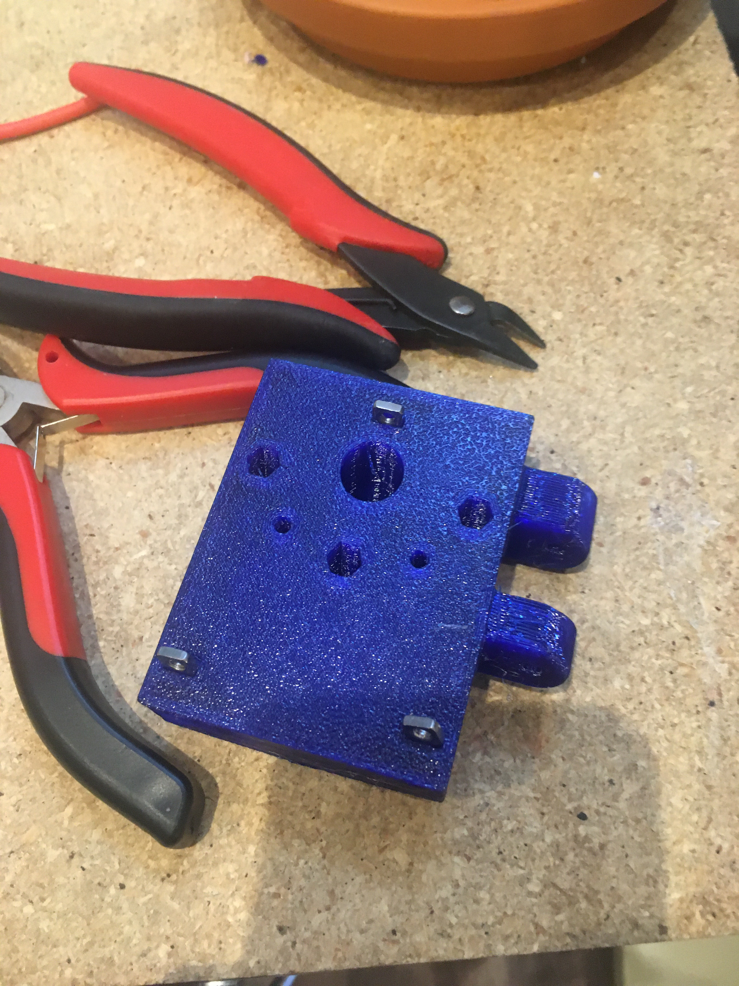
[picture p115: STL/BUILD_GUIDE/13_2_0.jpg]
STL/BUILD_GUIDE/13_2_0.jpg
